arekp/deskmate-diy/info.md

# Skills do tworzenia modeli 3d 
- https://github.com/earthtojake/text-to-cad
-
