arekp/deskmate-diy/hardware/renders/asm_34_fold8_open_pan80_tilt-25.png

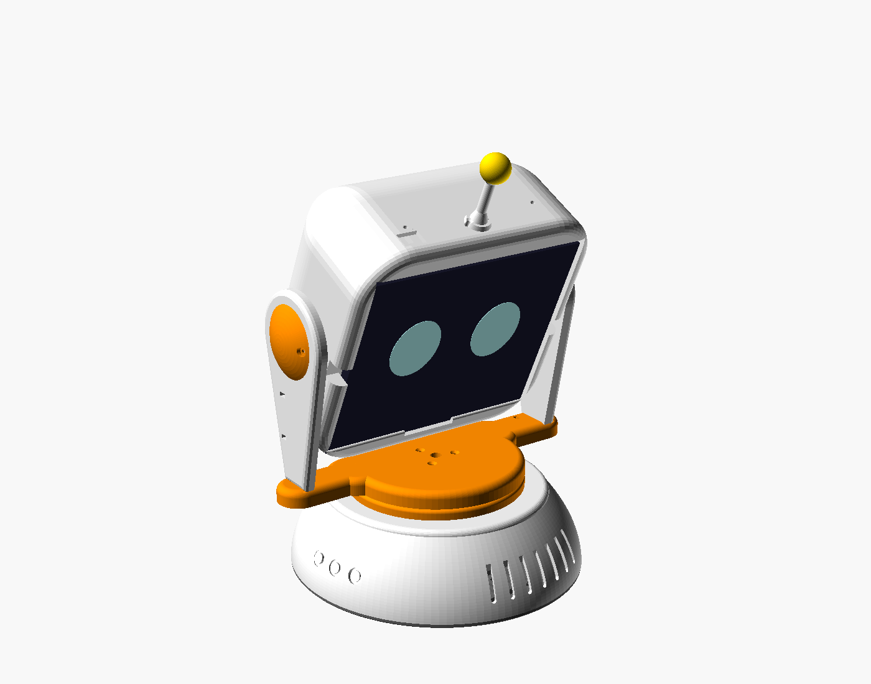
hardware/renders/asm_34_fold8_open_pan80_tilt-25.png
