arekp/deskmate-diy/hardware/renders/asm_back_fold8_open.png

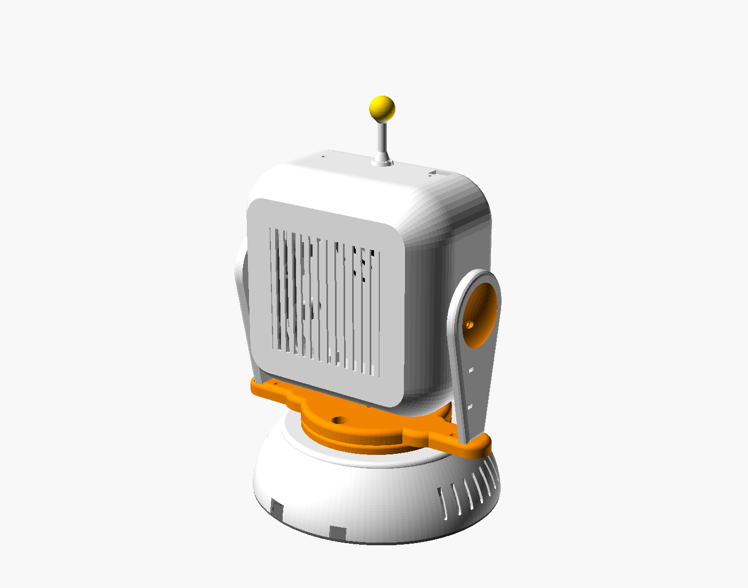
hardware/renders/asm_back_fold8_open.png
