arekp/deskmate-diy/hardware/renders/asm_side_flip6_open.png

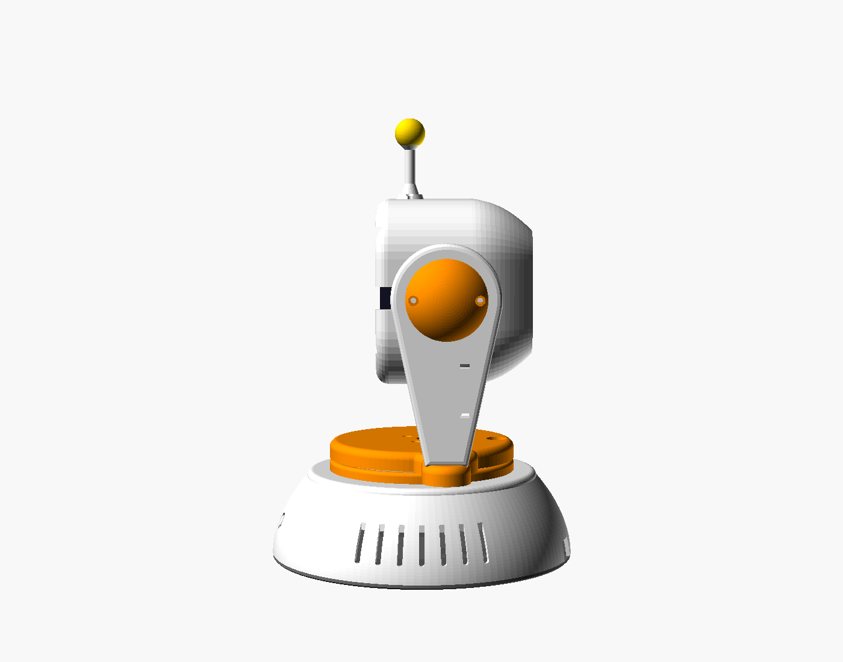
hardware/renders/asm_side_flip6_open.png
