arekp/deskmate-diy/hardware/renders/part_antenna.png

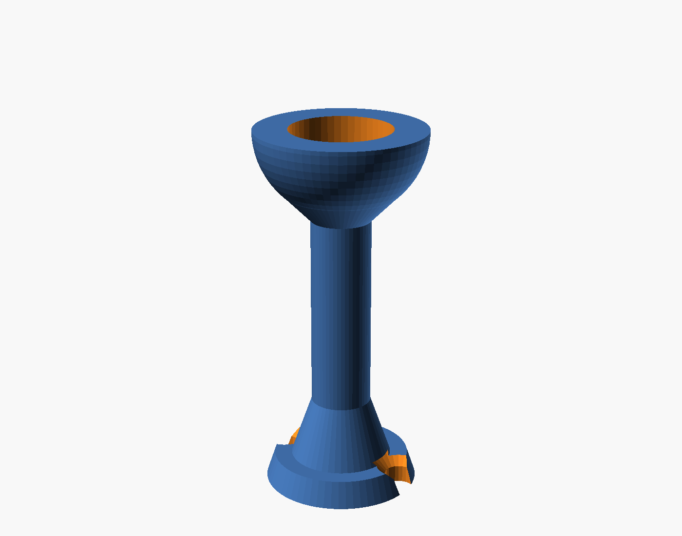
hardware/renders/part_antenna.png
