arekp/deskmate-diy/hardware/renders/part_arm_bearing.png

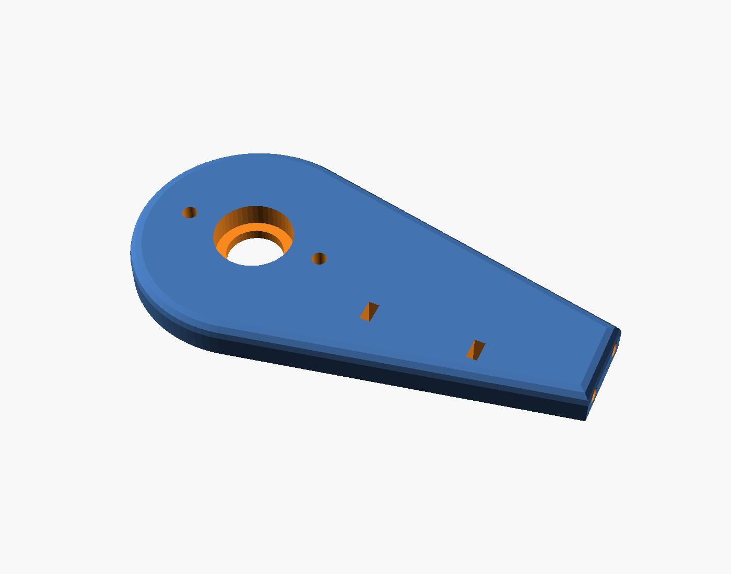
hardware/renders/part_arm_bearing.png
