arekp/deskmate-diy/hardware/renders/part_body.png

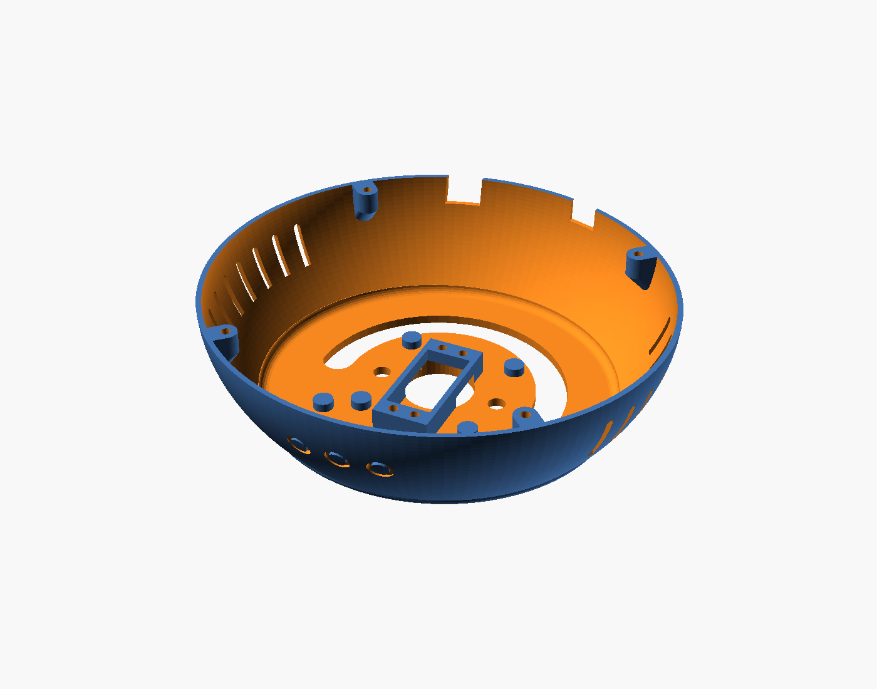
hardware/renders/part_body.png
