arekp/deskmate-diy/hardware/renders/part_cover.png

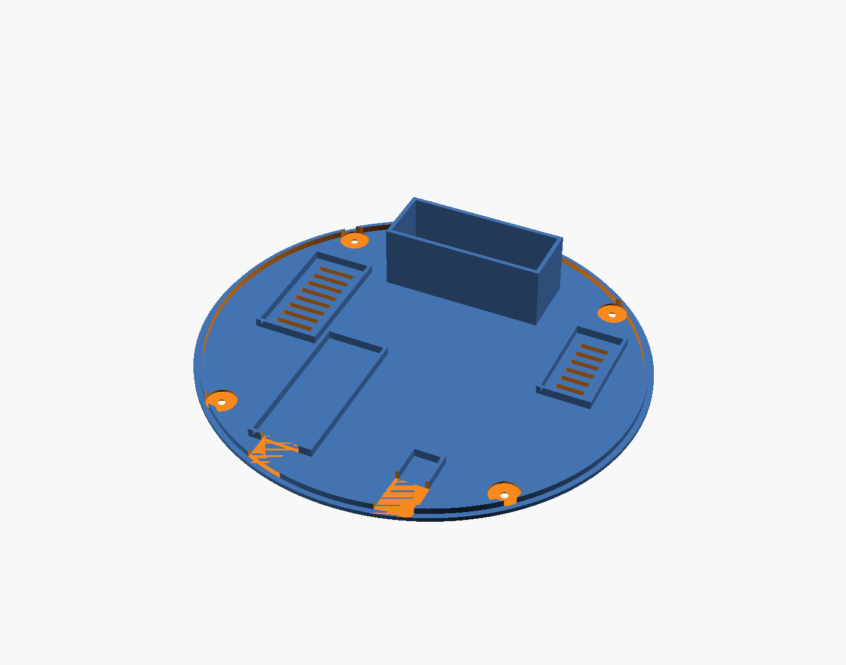
hardware/renders/part_cover.png
