arekp/deskmate-diy/hardware/renders/part_head_back_s23.png

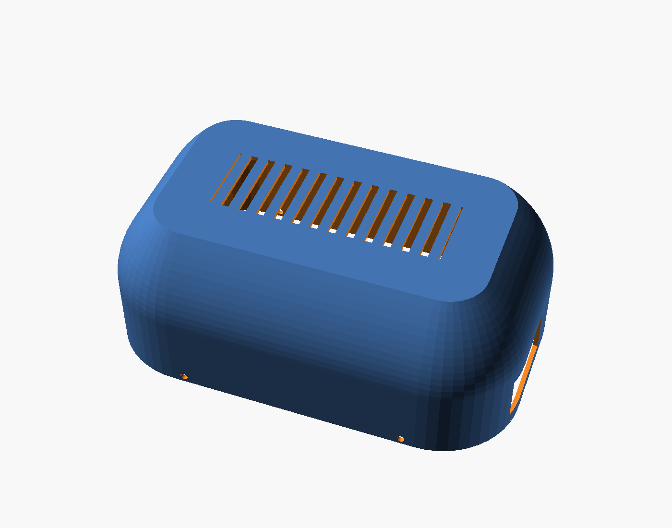
hardware/renders/part_head_back_s23.png
