arekp/deskmate-diy/hardware/renders/part_head_front_flip6_open.png

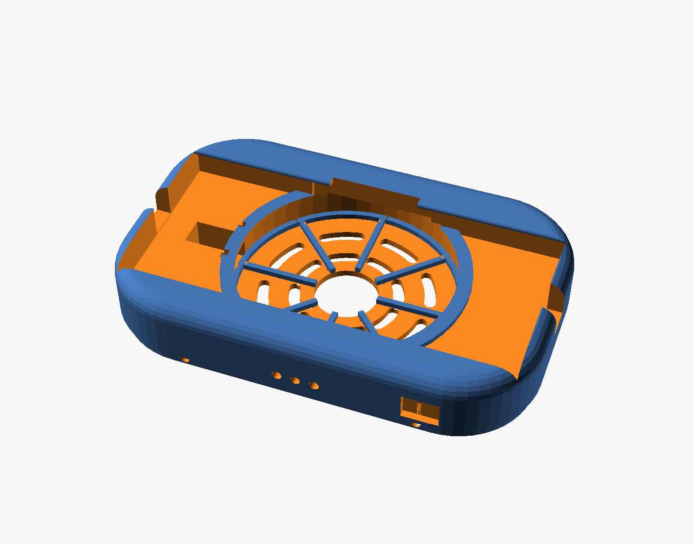
hardware/renders/part_head_front_flip6_open.png
