arekp/deskmate-diy/hardware/renders/part_head_front_fold8_open.png

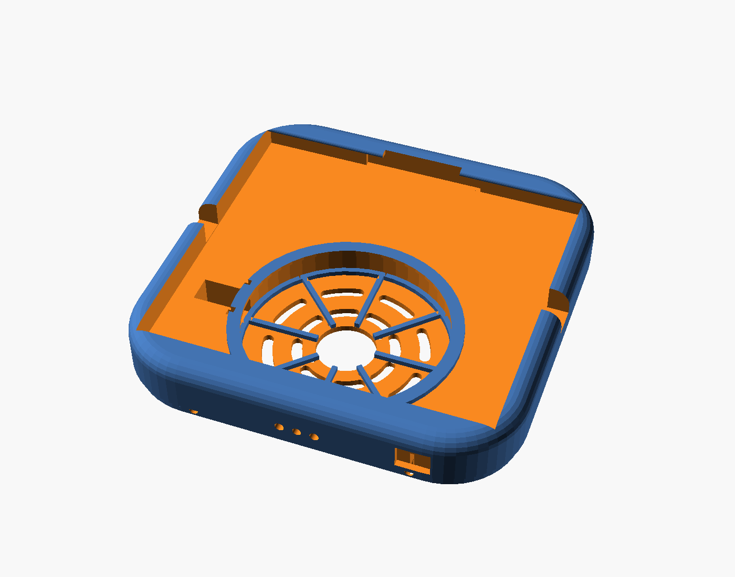
hardware/renders/part_head_front_fold8_open.png
