arekp/deskmate-diy/hardware/renders/part_head_mount_servo.png

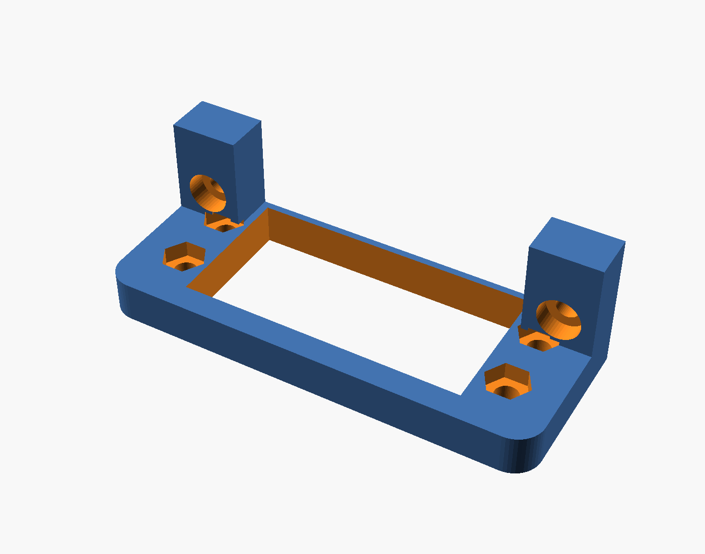
hardware/renders/part_head_mount_servo.png
