arekp/deskmate-diy/hardware/renders/part_magnet_disc_back.png

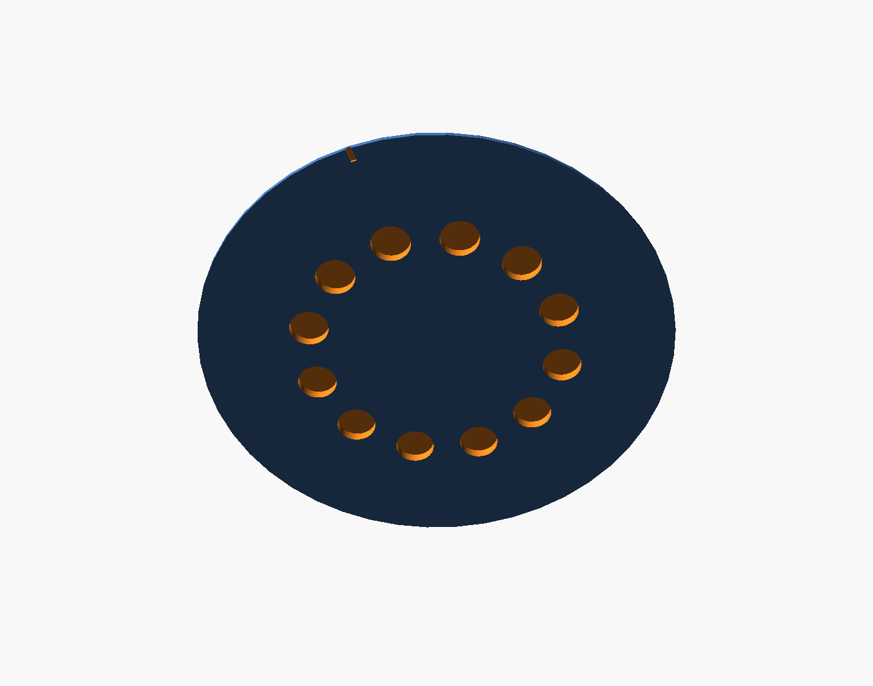
hardware/renders/part_magnet_disc_back.png
