arekp/deskmate-diy/hardware/renders/part_neck_shoulders.png

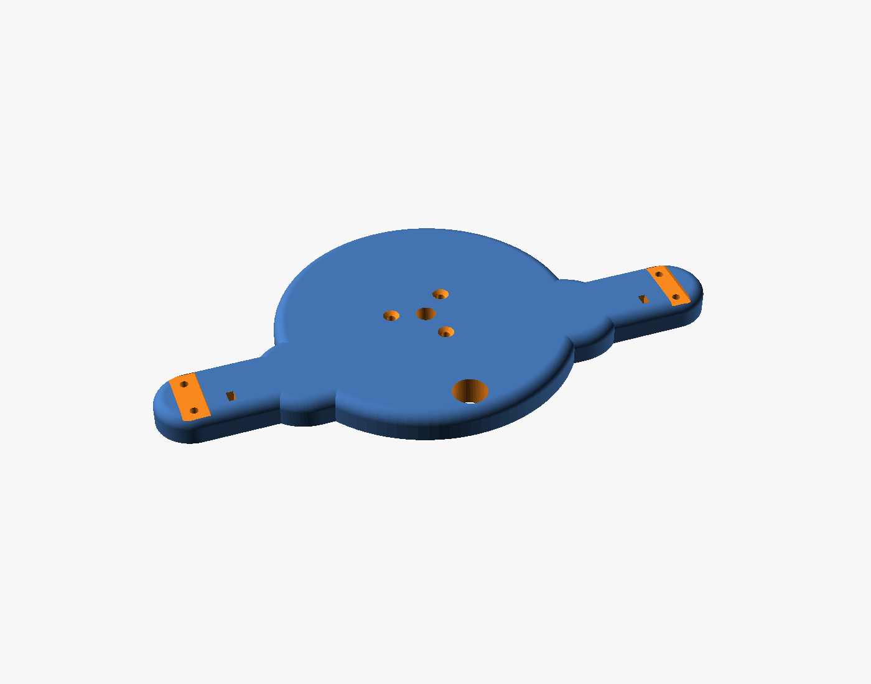
hardware/renders/part_neck_shoulders.png
