arekp/deskmate-diy/hardware/stl/head_back_flip6_open.stl

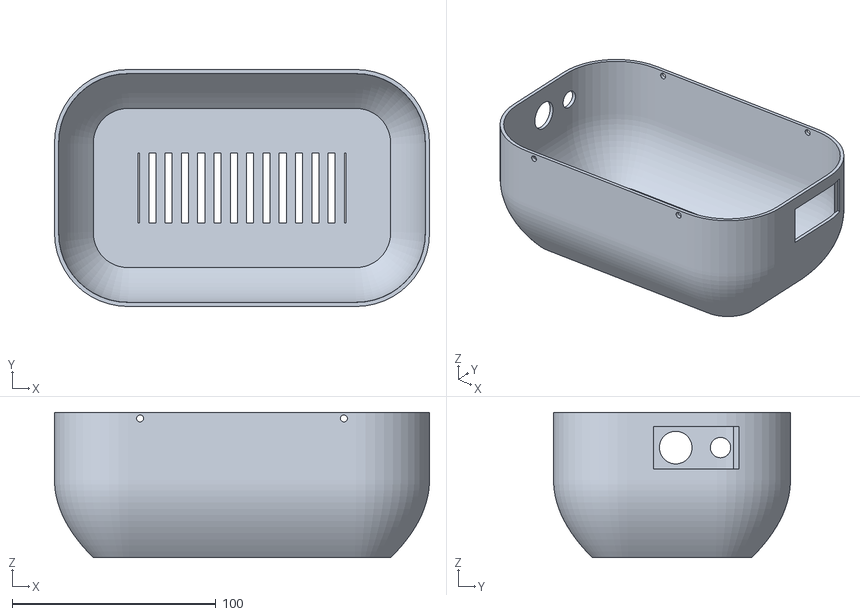
[picture p18: CAD file, 2026-11-03]
hardware/stl/head_back_flip6_open.stl
184.0 x 116.2 x 71.3
