arekp/deskmate-diy/hardware/stl/head_back_s23.stl

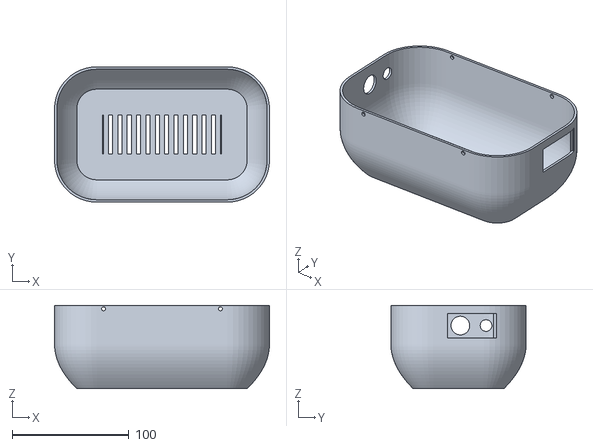
[picture p19: CAD file, 2026-11-03]
hardware/stl/head_back_s23.stl
184.0 x 115.8 x 71.3
