arekp/deskmate-diy/hardware/stl/head_back_fold8_open.stl

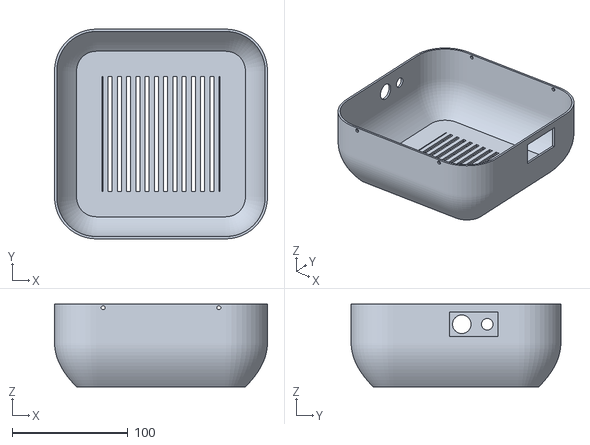
[picture p20: CAD file, 2026-11-03]
hardware/stl/head_back_fold8_open.stl
184.0 x 181.2 x 71.3
