arekp/deskmate-diy/hardware/stl/antenna.stl

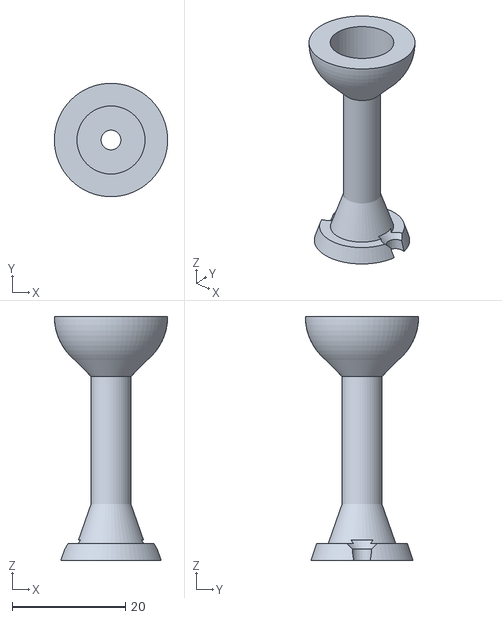
[picture p21: CAD file, 2026-11-02]
hardware/stl/antenna.stl
20.0 x 20.0 x 43.0
