arekp/deskmate-diy/hardware/stl/arm_servo.stl

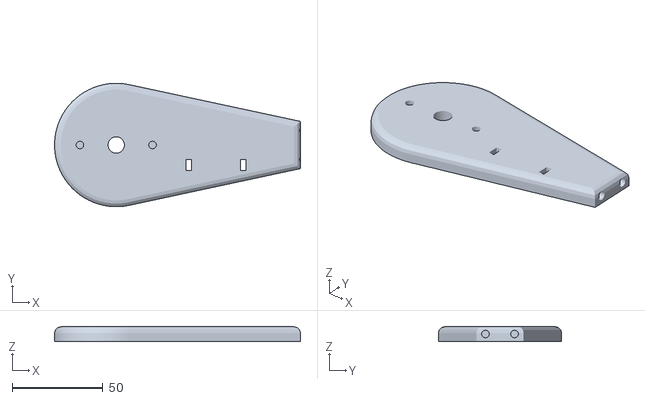
[picture p22: CAD file, 2026-11-02]
hardware/stl/arm_servo.stl
135.5 x 68.0 x 8.00
