arekp/deskmate-diy/hardware/stl/head_front_fold8_open.stl

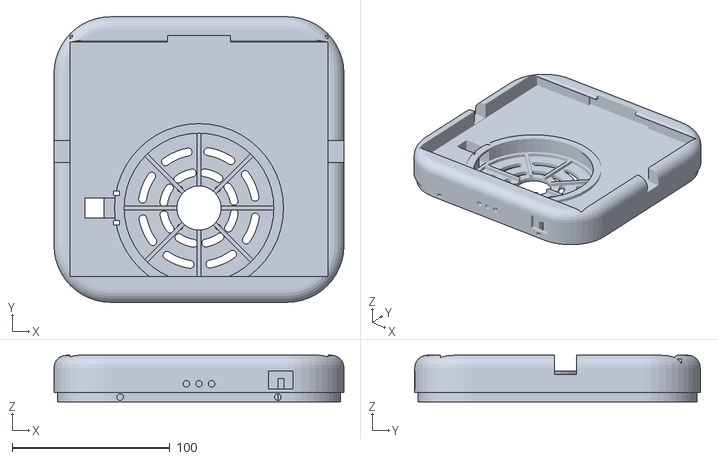
[picture p23: CAD file, 2026-11-02]
hardware/stl/head_front_fold8_open.stl
184.0 x 181.2 x 29.6
