arekp/deskmate-diy/hardware/stl/ear_cap_servo.stl

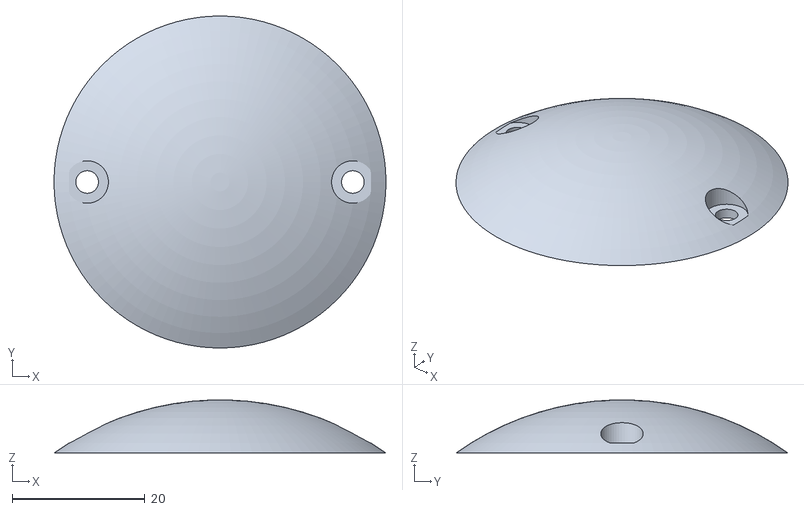
[picture p24: CAD file, 2026-11-02]
hardware/stl/ear_cap_servo.stl
50.0 x 50.0 x 7.98
