arekp/deskmate-diy/hardware/stl/head_mount_servo.stl

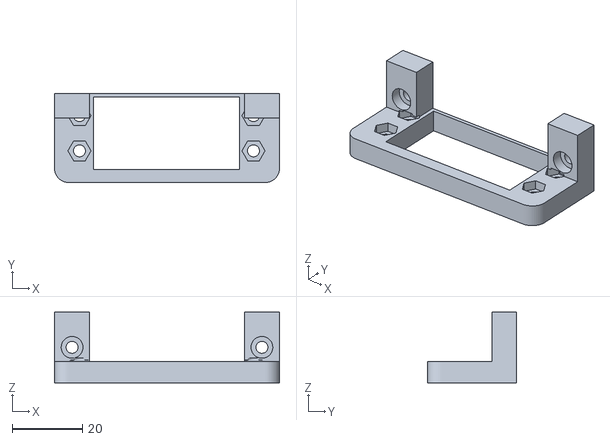
[picture p25: CAD file, 2026-11-02]
hardware/stl/head_mount_servo.stl
64.0 x 25.3 x 20.1
