arekp/deskmate-diy/hardware/stl/ear_cap_bearing.stl

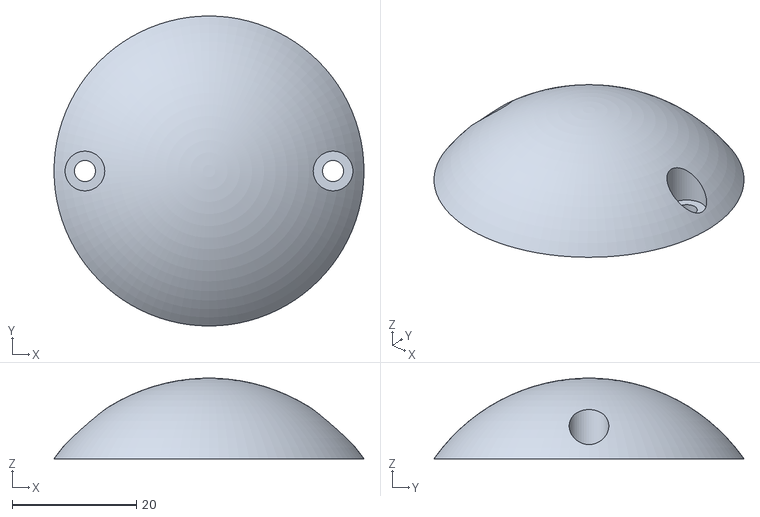
[picture p26: CAD file, 2026-11-02]
hardware/stl/ear_cap_bearing.stl
50.0 x 50.0 x 13.0
