arekp/deskmate-diy/hardware/stl/spacers.stl

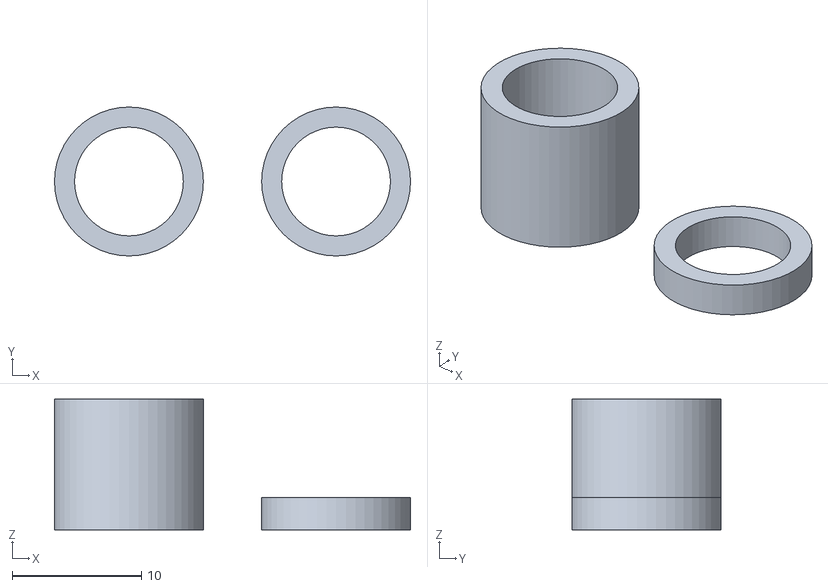
[picture p27: CAD file, 2026-11-02]
hardware/stl/spacers.stl
27.5 x 11.5 x 10.1
