arekp/deskmate-diy/hardware/stl/body_cover.stl

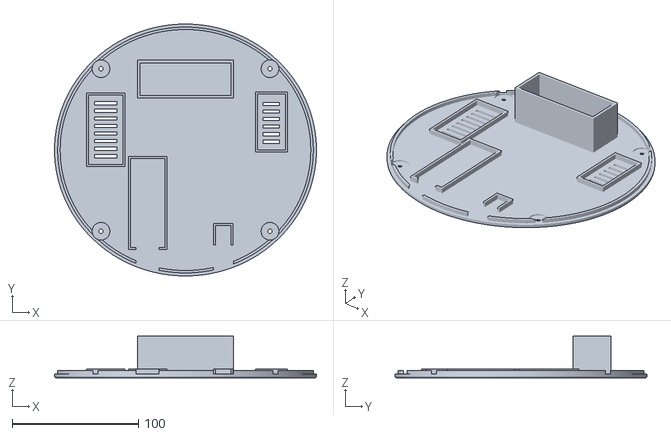
[picture p28: CAD file, 2026-11-02]
hardware/stl/body_cover.stl
207.2 x 199.3 x 33.0
