arekp/deskmate-diy/hardware/stl/antenna_cap.stl

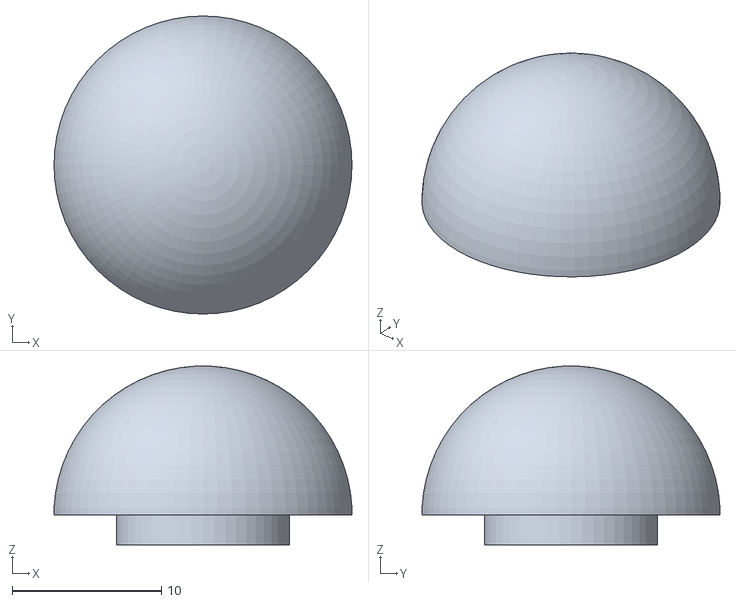
[picture p29: CAD file, 2026-11-02]
hardware/stl/antenna_cap.stl
20.0 x 20.0 x 12.0
