arekp/deskmate-diy/hardware/stl/neck_shoulders.stl

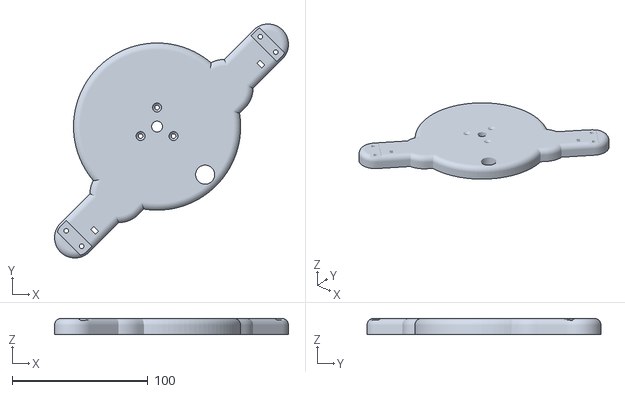
[picture p30: CAD file, 2026-11-02]
hardware/stl/neck_shoulders.stl
172.1 x 172.1 x 12.0
