arekp/deskmate-diy/hardware/stl/head_front_s23.stl

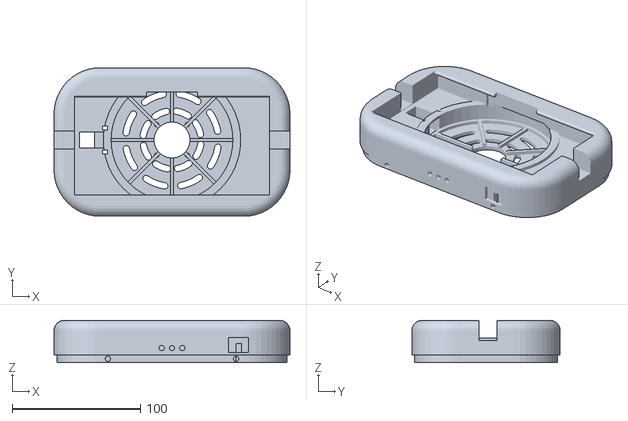
[picture p31: CAD file, 2026-11-02]
hardware/stl/head_front_s23.stl
184.0 x 115.8 x 33.1
