arekp/deskmate-diy/hardware/stl/head_mount_bearing.stl

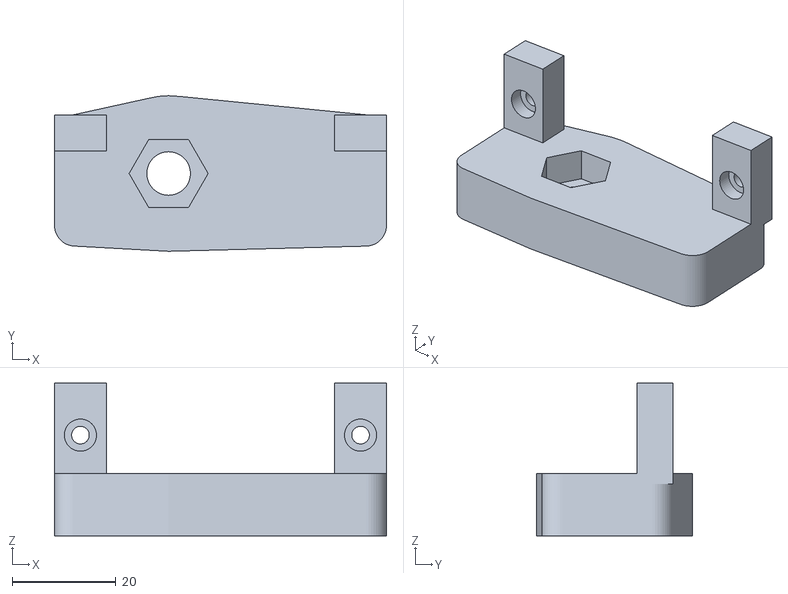
[picture p32: CAD file, 2026-11-02]
hardware/stl/head_mount_bearing.stl
64.0 x 30.0 x 29.4
