arekp/deskmate-diy/hardware/stl/arm_bearing.stl

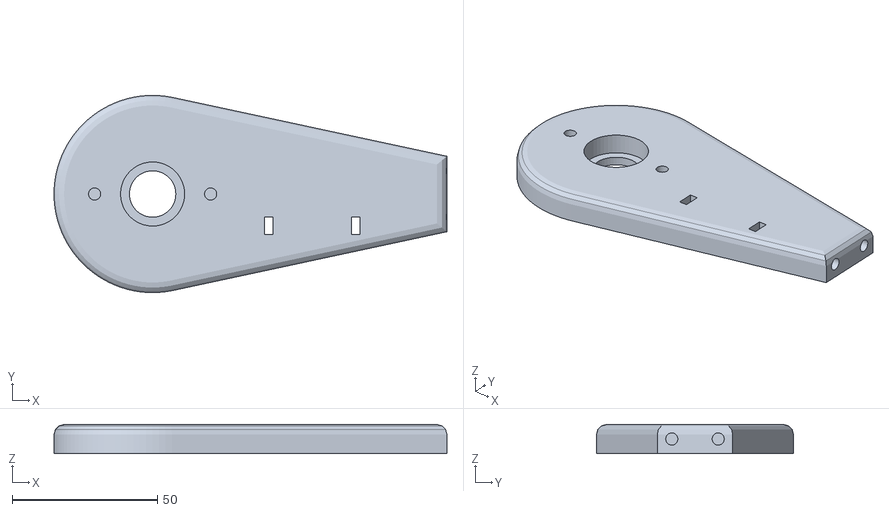
[picture p33: CAD file, 2026-11-02]
hardware/stl/arm_bearing.stl
135.5 x 68.0 x 10.0
