arekp/deskmate-diy/hardware/stl/head_front_fold8_closed.stl

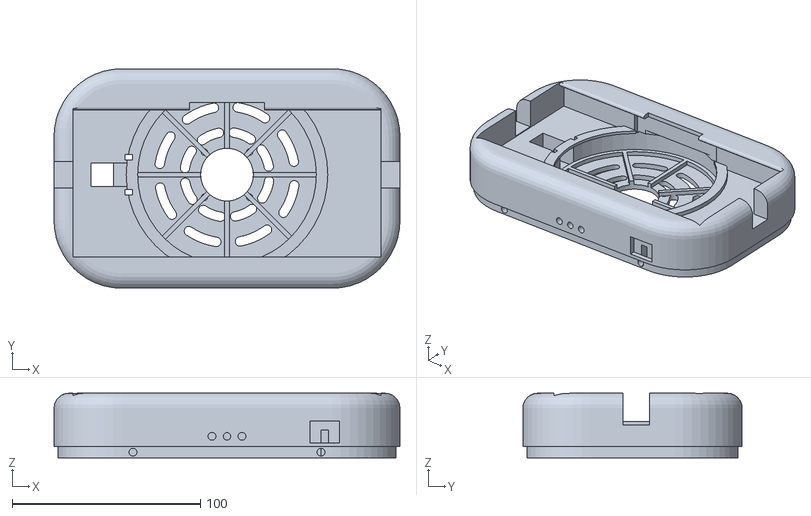
[picture p34: CAD file, 2026-11-02]
hardware/stl/head_front_fold8_closed.stl
184.0 x 116.7 x 34.4
