arekp/deskmate-diy/hardware/stl/pan_hub.stl

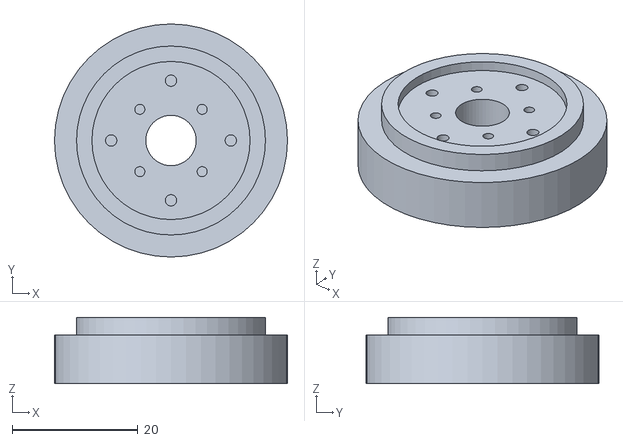
[picture p35: CAD file, 2026-11-02]
hardware/stl/pan_hub.stl
37.0 x 37.0 x 10.5
