arekp/deskmate-diy/hardware/stl/magnet_disc.stl

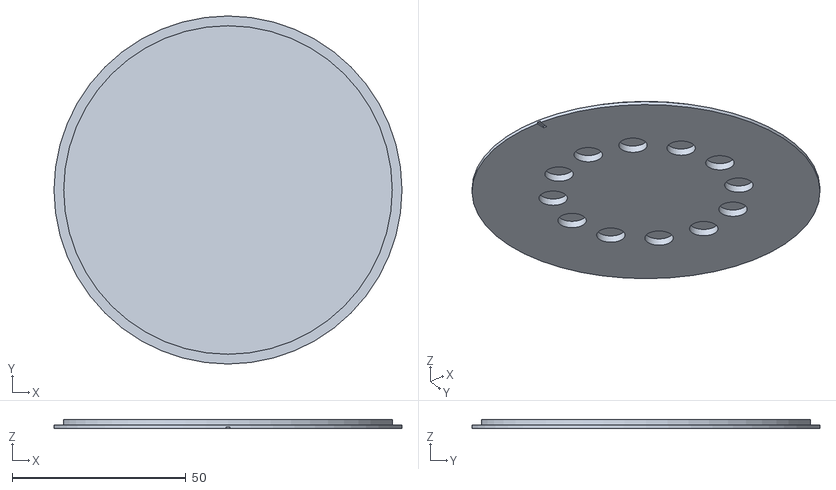
[picture p36: CAD file, 2026-11-02]
hardware/stl/magnet_disc.stl
100.2 x 100.2 x 2.70
