arekp/deskmate-diy/hardware/stl/neck_collar.stl

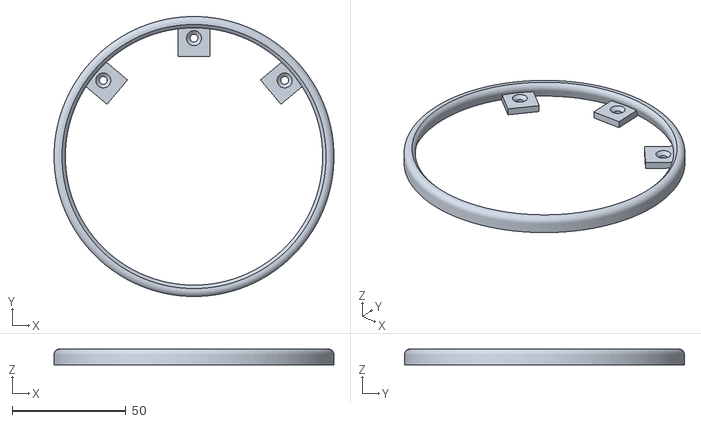
[picture p37: CAD file, 2026-11-02]
hardware/stl/neck_collar.stl
123.0 x 123.0 x 7.00
