arekp/deskmate-diy/hardware/stl/head_front_flip6_open.stl

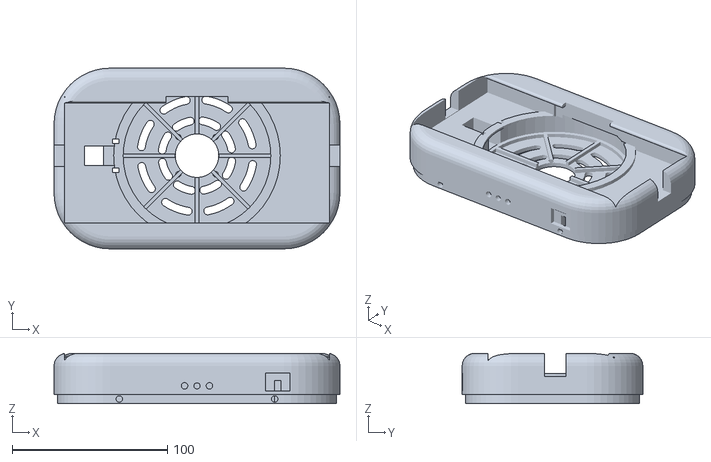
[picture p38: CAD file, 2026-11-02]
hardware/stl/head_front_flip6_open.stl
184.0 x 116.2 x 32.4
