arekp/deskmate-diy/hardware/stl/body.stl

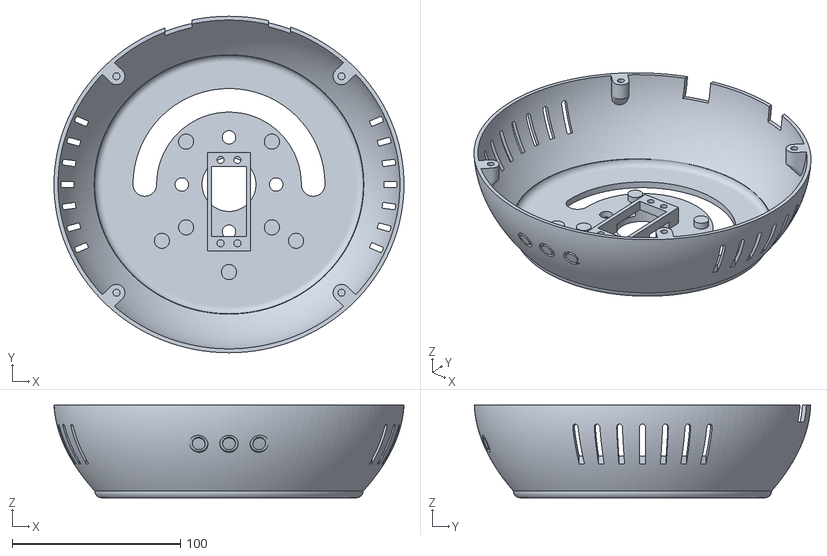
[picture p39: CAD file, 2026-11-02]
hardware/stl/body.stl
207.8 x 199.9 x 55.0
