arekp/deskmate-diy/hardware/cad/spacer.scad

// DeskMate DIY – tuleje osi TILT: wewnętrzna (uchwyt -> 608) i zewnętrzna (608 -> łeb M8)
ASM = true;
include <bracket.scad>
spacer();
translate([16, 0, 0]) spacer(2.5);
