arekp/deskmate-diy/(list of files, cad)

Other CAD files:
hardware/stl/head_back_fold8_closed.stl
