arekp/deskmate-diy/(commit log)

2026-11-01 Szkielet projektu DeskMate DIY: firmware ESP32, aplikacja Android, dokumentacja
    Biurkowy robot-asystent, którego mózgiem jest telefon z Androidem.
    Inspirowany Loona Deskmate (KEYi Tech) – niezależna implementacja.
2026-11-01 Wymiary ładowarki Anker 313 Pad z dokumentacji (Ø100 × 11,2 mm, 67 g)
    Claude-Session: https://claude.ai/code/session_01TSTn65wFshUxrv6beHqP24
2026-11-02 CAD (w toku): parametry części do druku 3D
    Wersja robocza – części i STL zostaną dodane po ukończeniu projektu.
    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
    [params.scad]
2026-11-02 Części do druku 3D: podstawa, jarzmo, wsporniki, płyty głowy z kołyską pod 4 profile telefonów
    - OpenSCAD (parametryczne), 15 plików STL (szczelne, jedna bryła), podglądy PNG
    - domyślna ładowarka Anker 313 Pad (Ø100, bez magnesów) – kołyska z półką i zaczepami,
    kieszeń z kanałem micro-USB, odciążeniem i wentylacją; presety Qi2 jako alternatywy
    - sprawdzenie kolizji (pan ±80°, tilt −25…+30°): brak; moment TILT ≤ 1,1 kg·cm; stabilność ≈ 28°
    - instrukcja druku i montażu: hardware/cad/README.md
    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
    [assembly.scad, base.scad, base.stl, bracket.scad, bracket_bearing.stl, bracket_servo.stl, clamp.scad, clamp_flip6_open.stl]
2026-11-02 Obudowa w stylu „ludzik na nóżce”: obły kask, uszy, szyja, tułów-jajo, antenka z diodą
    Nowe części: body, body_cover, neck_collar, neck_shoulders, arm_servo/bearing,
    ear_cap_*, head_front/head_back/visor dla 4 profili, head_mount_*, spacers,
    antenna, antenna_cap. Mechanika bez zmian (pan ±80°, tilt −25…+30°, Anker 313).
    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
    [antenna.scad, antenna.stl, antenna_cap.stl, arm_bearing.stl, arm_servo.stl, assembly.scad, base.scad, base.stl]
2026-11-02 Głowa: mocowanie magnetyczne (12× Ø8×2 N52 w krążku) + krótka półka, bez daszka
    Nowe: magnet_disc.scad/.stl, tools/magnet_check.py. Kolizje OK dla 4 profili,
    zapas siły trzymania ≥ 5× (tilt −25°, współczynnik dynamiczny 2).
    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
    [antenna.stl, antenna_cap.stl, arm_bearing.stl, arm_servo.stl, assembly.scad, body.stl, body_cover.stl, ear_cap_bearing.stl]
2026-11-03 Raport drukowalności STL: skill dfam-check (text-to-cad, MIT) + job CI printability
    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
2026-11-03 head_back: STL w orientacji do druku (płaski tył na stole) i zgodny ze źródłem
    Wykryte raportem DfAM (job printability): skorupa była odwrócona
    (rotate -90 zamiast +90) i 37 mm nad stołem, a pliki nieaktualne względem CAD.
    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
    [head_back.scad, head_back_flip6_open.stl, head_back_fold8_closed.stl, head_back_fold8_open.stl, head_back_s23.stl]
2026-11-03 Tryb debug w pasku: silnik i czasy STT/TTS, czas LLM; wybór usługi STT i silnika TTS
    Włączanie w ustawieniach (Diagnostyka) albo głosowo: „tryb debug” / „wyłącz debug”
    (obsługiwane lokalnie). Testy: DebugModeTest.
    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
2026-11-03 Robot nie ucina już odpowiedzi; okienko podglądu kamery w prawym górnym rogu
    - przerywanie głosem domyślnie wyłączone i ostrzejsze (14 dB, 450 ms), podniesiona ręka nie przerywa,
    machanie dopiero po 1 s mówienia
    - większy limit tokenów dla OpenRouter/Claude, urwane zdanie na końcu jest obcinane (SpeechText)
    - CameraPip: podgląd przedniej kamery, ramka twarzy, uśmiech, ręka, etykiety ML Kit (ustawienie Ekran)
    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
2026-11-03 Poprawki z logów: wiadomości bez klucza (Google News RSS), lepsza Wikipedia, filtr rozumowania, profil S23 Ultra
    - web_search bez klucza Gemini: nagłówki Google News + Wikipedia z oczyszczonym zapytaniem
    - ReasoningFilter: model nie czyta na głos swoich notatek; OpenRouter reasoning.exclude
    - prompt: ufaj dacie i wynikom, jedno wyszukiwanie, bez opisywania rozumowania
    - DeviceProfile: Galaxy S23 Ultra (SM-S918), S23+ w profilu S23
    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
2026-11-03 Pamięć projektu: telefon właściciela to Galaxy S23 Ultra (SM-S918B), do zrobienia profil CAD
    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
2026-11-07 Gemini: zapas przy 503 przeciążeniu, migracja gemini-flash-latest → gemini-3.8-flash; MCP: starszy transport SSE (HTTP 405)
    - GeminiModels: 503 high demand → kolejny model; lista stabilnych kodów (listopad 2026)
    - Settings v2: alias gemini-flash-latest zamieniany na gemini-3.8-flash
    - McpClient: automatyczne przejście na SSE (/mcp_server/sse) przy 405/404 albo adresie …/sse; test z udawanym HA
    - status MCP pokazuje transport
    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
